Davis-Autonomy-Club/delivery-robot/docs/CURRENT_AMAZON_CART_SYNC.md

# Current Amazon Cart Sync

Updated after the manual Amazon cart trim on May 16, 2026.

This file records what is actually in the active Amazon cart so the repo does not drift away from the purchase state. It does not replace the full bill of materials in [`SHOPPING_LIST.md`](SHOPPING_LIST.md): the robot also needs the Pololu cart and any items marked below as already-owned, lab-supplied, or not currently active.

## Active Cart Summary

- Active Amazon cart: 36 line items, 38 units.
- Amazon subtotal shown in cart: $617.05 before tax and shipping.
- Pololu cart verified live on May 16, 2026: $379.35 before tax and shipping.
- Combined pre-tax purchase subtotal if the Pololu cart is unchanged: $996.40.

## Active Pololu Cart Items

| Qty | Active Pololu item | Product | Each | Line |
| ---: | --- | --- | ---: | ---: |
| 4 | 30:1 Metal Gearmotor 37Dx68L mm 12V with 64 CPR Encoder | [#4752](https://www.pololu.com/product/4752) | $60.95 | $243.80 |
| 4 | Machined Aluminum Bracket for 37D mm Metal Gearmotors | [#1995](https://www.pololu.com/product/1995) | $12.95 | $51.80 |
| 2 | 12 mm Hex Wheel Adapter for 6 mm Shaft, 2-pack | [#2686](https://www.pololu.com/product/2686) | $6.95 | $13.90 |
| 2 | 5 V, 5 A Step-Down Voltage Regulator D24V50F5 | [#2851](https://www.pololu.com/product/2851) | $29.95 | $59.90 |
| 1 | ACS724LLCTR-30AU Current Sensor Carrier 0 A to 30 A | [#4046](https://www.pololu.com/product/4046) | $9.95 | $9.95 |

## Active Amazon Cart Items

| Qty | Active Amazon item | ASIN | Cart price |
| ---: | --- | --- | ---: |
| 1 | B6 80W LiPo balance charger | [B0F2H3XR6S](https://www.amazon.com/dp/B0F2H3XR6S) | $38.98 |
| 1 | Foam edge bumper | [B086Z5B5B5](https://www.amazon.com/dp/B086Z5B5B5) | $9.99 |
| 1 | MC-31B lid reed switch 2-pack | [B0BX2ZRZ8T](https://www.amazon.com/dp/B0BX2ZRZ8T) | $9.99 |
| 1 | 22 mm NC emergency stop 2-pack | [B07R8PTTDX](https://www.amazon.com/dp/B07R8PTTDX) | $11.99 |
| 1 | Waterproof cable gland kit | [B09Z24H77M](https://www.amazon.com/dp/B09Z24H77M) | $12.99 |
| 1 | USB A-to-B Mega cable | [B00P0FO1P0](https://www.amazon.com/dp/B00P0FO1P0) | $5.99 |
| 1 | BTS7960 motor driver 4-pack | [B0FND3VTGK](https://www.amazon.com/dp/B0FND3VTGK) | $22.99 |
| 1 | Arduino Mega 2560 Rev3 | [B0046AMGW0](https://www.amazon.com/dp/B0046AMGW0) | $49.90 |
| 1 | 22 AWG silicone signal wire kit | [B0DWJSB65V](https://www.amazon.com/dp/B0DWJSB65V) | $14.99 |
| 1 | M2 screw/nut kit | [B0FGV5K8BT](https://www.amazon.com/dp/B0FGV5K8BT) | $9.99 |
| 1 | Prototype perfboard kit | [B072Z7Y19F](https://www.amazon.com/dp/B072Z7Y19F) | $9.99 |
| 1 | Resistor assortment | [B07P3MFG5D](https://www.amazon.com/dp/B07P3MFG5D) | $12.99 |
| 1 | Short USB cable assortment | [B0BZYKPCR5](https://www.amazon.com/dp/B0BZYKPCR5) | $13.99 |
| 1 | EIOTCLUB LTE data SIM | [B0DJ2SQZTQ](https://www.amazon.com/dp/B0DJ2SQZTQ) | $7.00 |
| 1 | Waveshare SIM7600G-H LTE USB dongle | [B08CSB596W](https://www.amazon.com/dp/B08CSB596W) | $78.71 |
| 2 | Arducam 1080p USB camera module | [B0CGLW3Z1N](https://www.amazon.com/dp/B0CGLW3Z1N) | $39.99 each |
| 1 | USB-C power pigtail 5-pack | [B0BFHXWCS9](https://www.amazon.com/dp/B0BFHXWCS9) | $9.99 |
| 1 | MG90S metal gear micro servo 2-pack | [B0BWJ4RKGV](https://www.amazon.com/dp/B0BWJ4RKGV) | $8.88 |
| 2 | Zeee 3S 5200 mAh XT60 LiPo | [B0972RKJDS](https://www.amazon.com/dp/B0972RKJDS) | $34.99 each |
| 1 | Precision screwdriver set | [B0D633J3C7](https://www.amazon.com/dp/B0D633J3C7) | $9.99 |
| 1 | Heat-shrink tubing kit | [B01MFA3OFA](https://www.amazon.com/dp/B01MFA3OFA) | $7.99 |
| 1 | XT60 pigtail kit | [B09M6KQWBL](https://www.amazon.com/dp/B09M6KQWBL) | $11.99 |
| 1 | Dupont jumper wire kit | [B01EV70C78](https://www.amazon.com/dp/B01EV70C78) | $6.98 |
| 1 | 18 AWG silicone wire | [B07FMRDP87](https://www.amazon.com/dp/B07FMRDP87) | $12.98 |
| 1 | 14 AWG silicone wire | [B0746H96QK](https://www.amazon.com/dp/B0746H96QK) | $9.88 |
| 1 | Silicone mat set | [B0CFTP6JR4](https://www.amazon.com/dp/B0CFTP6JR4) | $8.99 |
| 1 | Small zip ties | [B0DS6B9W4X](https://www.amazon.com/dp/B0DS6B9W4X) | $2.99 |
| 1 | M3 nylon standoff kit | [B0F297R23T](https://www.amazon.com/dp/B0F297R23T) | $8.59 |
| 1 | M3 x 8 screws | [B07CMQ1SQH](https://www.amazon.com/dp/B07CMQ1SQH) | $6.96 |
| 1 | M3 nyloc nuts | [B0DZ2V6PRF](https://www.amazon.com/dp/B0DZ2V6PRF) | $4.99 |
| 1 | M3 washers | [B0DDTNVRZW](https://www.amazon.com/dp/B0DDTNVRZW) | $5.49 |
| 1 | M3 x 20-40 screw assortment | [B0CR35WB16](https://www.amazon.com/dp/B0CR35WB16) | $9.79 |
| 1 | M3 x 12 screws | [B07CNFTK99](https://www.amazon.com/dp/B07CNFTK99) | $6.96 |
| 1 | 5 V red LED strip | [B0CMCN9Z2K](https://www.amazon.com/dp/B0CMCN9Z2K) | $6.19 |
| 1 | HC-SR04 ultrasonic sensors 2-pack | [B0B1MJJLJP](https://www.amazon.com/dp/B0B1MJJLJP) | $6.99 |
| 1 | XT60 loop/main switch | [B0B1C88LSM](https://www.amazon.com/dp/B0B1C88LSM) | $9.99 |

## Robot-Relevant Items Not In The Active Cart

These were visible outside the active cart or are required by the build but absent from the current active Amazon cart. Do not start the build unless each one is either already on hand, bought elsewhere, or deliberately replaced with an equivalent part.

| Item | Current cart state | Why it still matters |
| --- | --- | --- |
| 120 mm / 12 mm-hex wheel set, [B09KTKGZGF](https://www.amazon.com/dp/B09KTKGZGF) | Saved for later, not active | Required for the drivetrain unless a compatible wheel set is already on hand. |
| Automotive blade fuse kit, [B0899WR671](https://www.amazon.com/dp/B0899WR671) | Saved for later, not active | Required for the fused battery input unless matching 25 A and 30 A fuses are already on hand. |
| Inline blade fuse holders, [B07426WCLM](https://www.amazon.com/dp/B07426WCLM) | Saved for later, not active | Required near battery positive unless an equivalent rated fuse holder is already on hand. |
| WAGO 221 distribution connectors, [B0CJ5QF3VX](https://www.amazon.com/dp/B0CJ5QF3VX) | Saved for later, not active | Required unless an equivalent rated positive/negative distribution block is used. |
| White PETG filament, [B07PDV9RC8](https://www.amazon.com/dp/B07PDV9RC8) | Removed from cart | Required unless PETG/PLA filament is already available from the lab. |
| Clear/natural PETG or PLA | Not active | Only needed for the front LED diffuser; can be skipped if the diffuser is omitted. |
| Raspberry Pi 4 and microSD card | Not active | Required for the current two-camera/LTE plan unless a Pi and microSD are already on hand. |
| Velcro battery straps | Not active | Required to restrain the battery unless an equivalent strap is already on hand. |
| LiPo-safe charging bag | Not active | Required for safe LiPo charging/storage unless the existing Zeee bag is being used. |
| Multimeter, wire stripper, crimper/soldering iron, needle-nose pliers, hex keys, flush cutters | Not active | Required tools; okay to omit from cart only if the shop/lab already has them. |
| 3D printer | Not active | Fine to omit if printing is outsourced or a printer is already available. |

Known saved-for-later add-back subtotal for wheels, fuses, fuse holders, and WAGO connectors is at least $68.82 before tax/shipping. The real all-in build cost is therefore above the $996.40 active-cart subtotal unless those items are already owned or replaced by equivalents.

## Compatibility Notes From This Sync

- The current Amazon cart is below the $1,000 pre-tax target only because several required build/support items are not active in Amazon.
- Cameras, LTE modem, USB-C pigtails, and short USB cables are active, but the Raspberry Pi and microSD card are not. That is compatible only if a Pi and microSD are already available.
- The B6 charger is still active even though an OVONIC X1 Dual charger may be available. If the OVONIC charger will be used, remove the B6 charger from the Amazon cart and mark the charger as already-owned in `SHOPPING_LIST.md`.
- XT60 pigtails are still active even though MCIGICM XT60H connectors may be available. Keeping the pigtail kit is reasonable for quick wiring; delete it only if the team is comfortable soldering XT60H connectors directly.
