Davis-Autonomy-Club/delivery-robot/cad/print-ready/full-size/v2_robot_complete_reference_not_for_print.stl

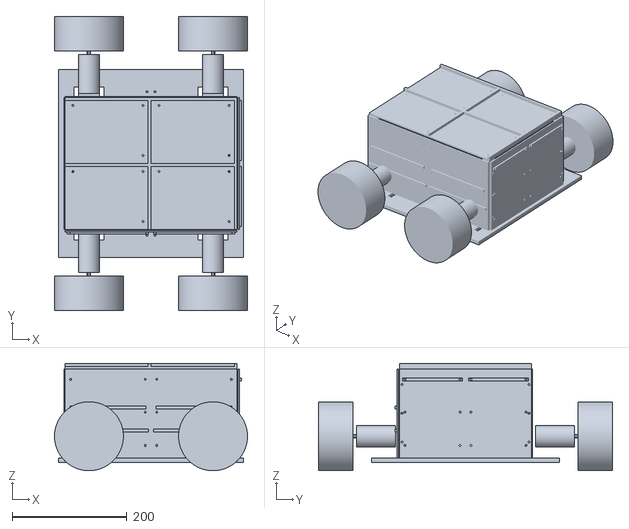
[picture p1: CAD file, 2026-05-16]
cad/print-ready/full-size/v2_robot_complete_reference_not_for_print.stl
336.0 x 512.0 x 187.0
