Davis-Autonomy-Club/delivery-robot/cad/print-ready/full-size/v2_base_plate_full_size.stl

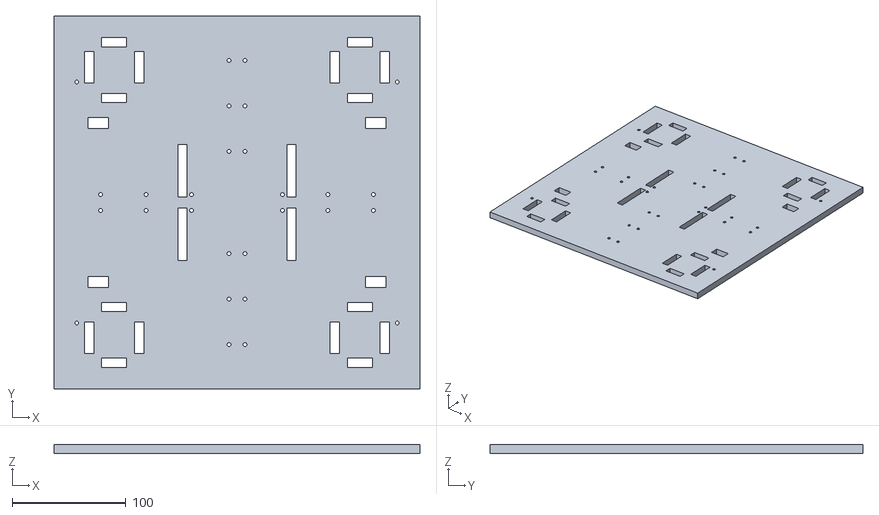
[picture p2: CAD file, 2026-05-16]
cad/print-ready/full-size/v2_base_plate_full_size.stl
322.0 x 328.0 x 8.00
