Davis-Autonomy-Club/delivery-robot/cad/print-ready/full-size/original_four_piece_base_merged_full_size.stl

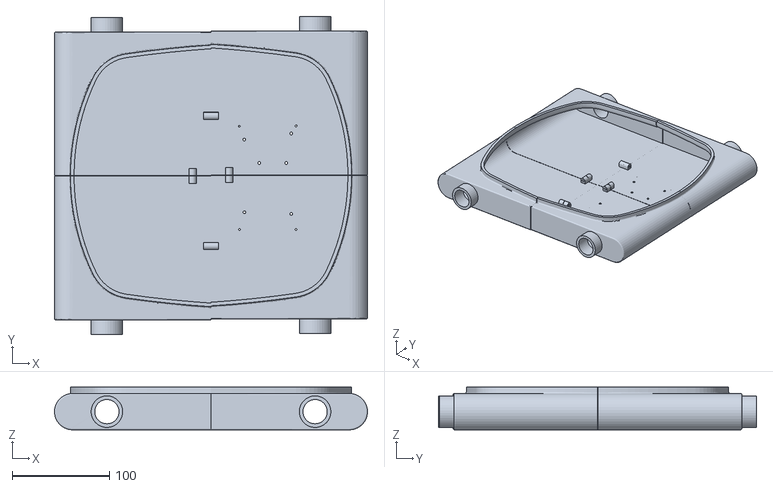
[picture p3: CAD file, 2026-05-16]
cad/print-ready/full-size/original_four_piece_base_merged_full_size.stl
322.3 x 327.6 x 44.0
