Davis-Autonomy-Club/delivery-robot/cad/print-ready/body/side_panel_front_half_print_2.stl

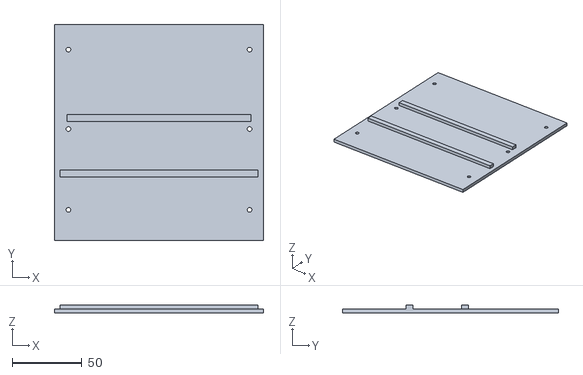
[picture p4: CAD file, 2026-05-16]
cad/print-ready/body/side_panel_front_half_print_2.stl
150.0 x 155.0 x 6.00
