Davis-Autonomy-Club/delivery-robot/cad/print-ready/cargo/cargo_floor_rear_right.stl

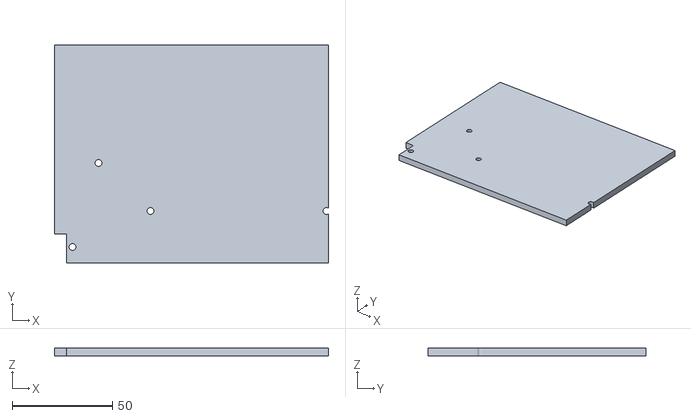
[picture p5: CAD file, 2026-05-16]
cad/print-ready/cargo/cargo_floor_rear_right.stl
137.0 x 109.0 x 4.00
