Davis-Autonomy-Club/delivery-robot/cad/print-ready/chassis/base_plate_front_left.stl

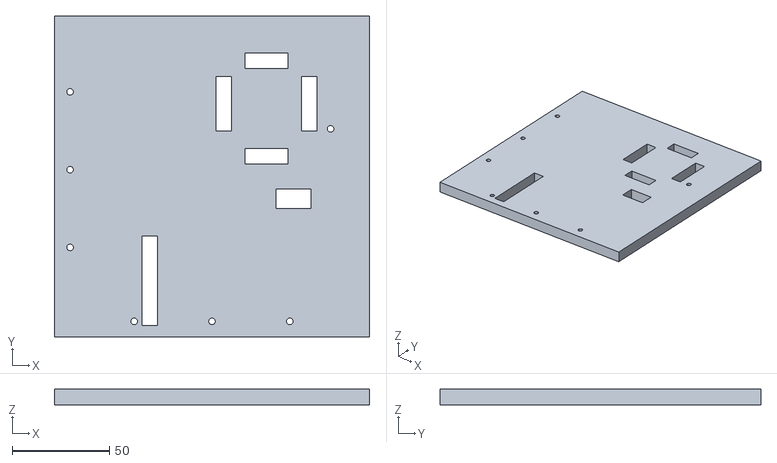
[picture p6: CAD file, 2026-05-16]
cad/print-ready/chassis/base_plate_front_left.stl
162.0 x 165.0 x 8.00
