Davis-Autonomy-Club/delivery-robot/cad/print-ready/electronics/buck_converter_plate.stl

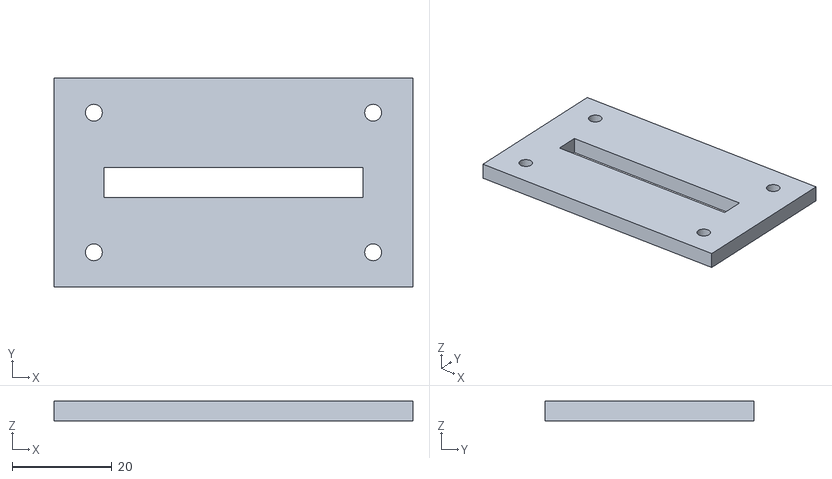
[picture p7: CAD file, 2026-05-16]
cad/print-ready/electronics/buck_converter_plate.stl
72.0 x 42.0 x 4.00
