Davis-Autonomy-Club/delivery-robot/cad/print-ready/body/rear_panel_left.stl

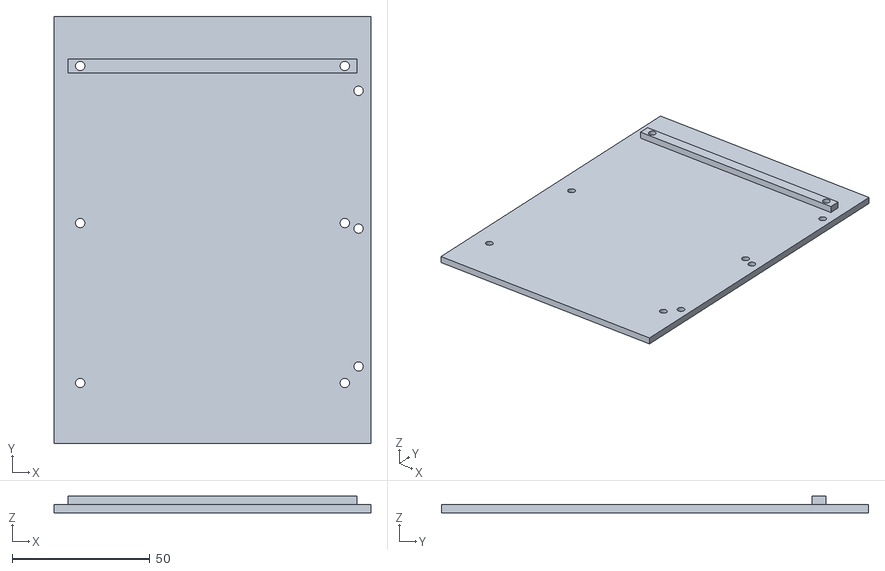
[picture p8: CAD file, 2026-05-16]
cad/print-ready/body/rear_panel_left.stl
115.0 x 155.0 x 6.00
