Davis-Autonomy-Club/delivery-robot/cad/print-ready/chassis/base_seam_joiner_short_print_2.stl

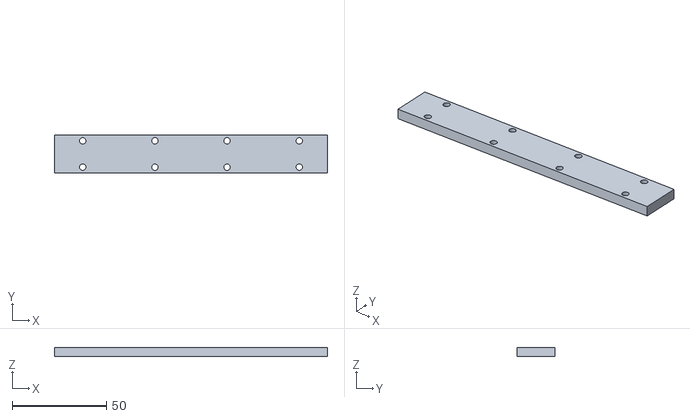
[picture p9: CAD file, 2026-05-16]
cad/print-ready/chassis/base_seam_joiner_short_print_2.stl
145.0 x 20.0 x 5.00
