Davis-Autonomy-Club/delivery-robot/cad/print-ready/electronics/bts7960_dual_driver_tray_print_2.stl

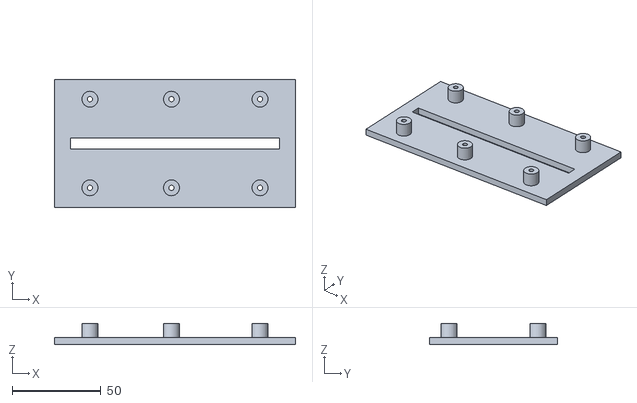
[picture p10: CAD file, 2026-05-16]
cad/print-ready/electronics/bts7960_dual_driver_tray_print_2.stl
136.0 x 72.0 x 12.0
