Davis-Autonomy-Club/delivery-robot/cad/print-ready/electronics/3s_lipo_battery_sled.stl

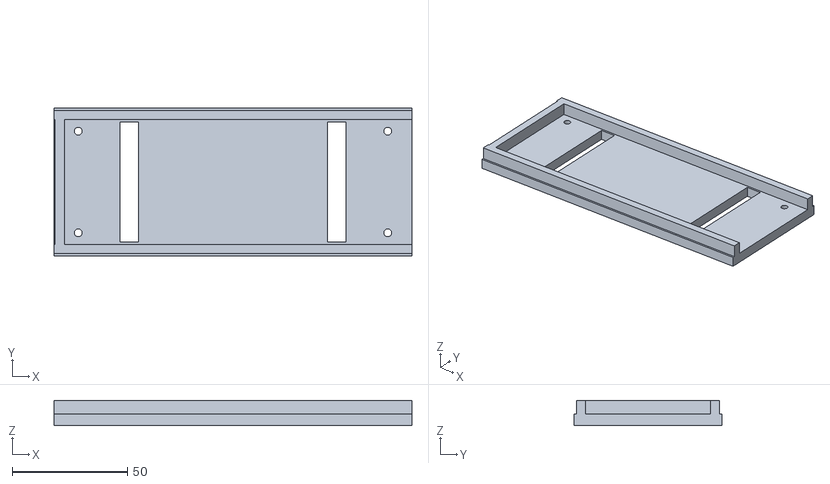
[picture p11: CAD file, 2026-05-16]
cad/print-ready/electronics/3s_lipo_battery_sled.stl
155.0 x 64.0 x 11.0
