Davis-Autonomy-Club/delivery-robot/cad/print-ready/body/corner_post_print_4.stl

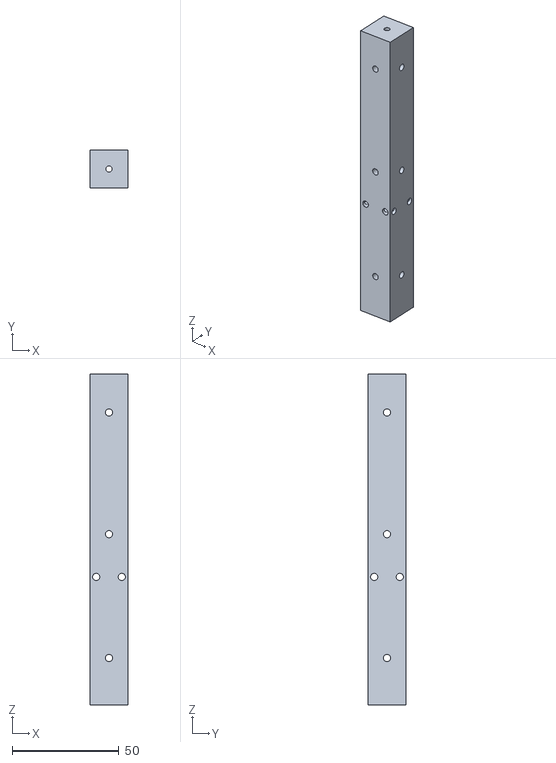
[picture p12: CAD file, 2026-05-16]
cad/print-ready/body/corner_post_print_4.stl
18.0 x 18.0 x 155.0
