Davis-Autonomy-Club/delivery-robot/cad/print-ready/electronics/arduino_mega_controller_tray.stl

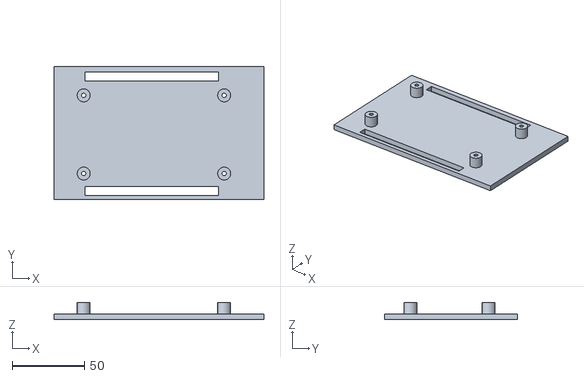
[picture p13: CAD file, 2026-05-16]
cad/print-ready/electronics/arduino_mega_controller_tray.stl
145.0 x 92.0 x 12.0
