Davis-Autonomy-Club/delivery-robot/cad/print-ready/body/panel_center_joiner_print_4.stl

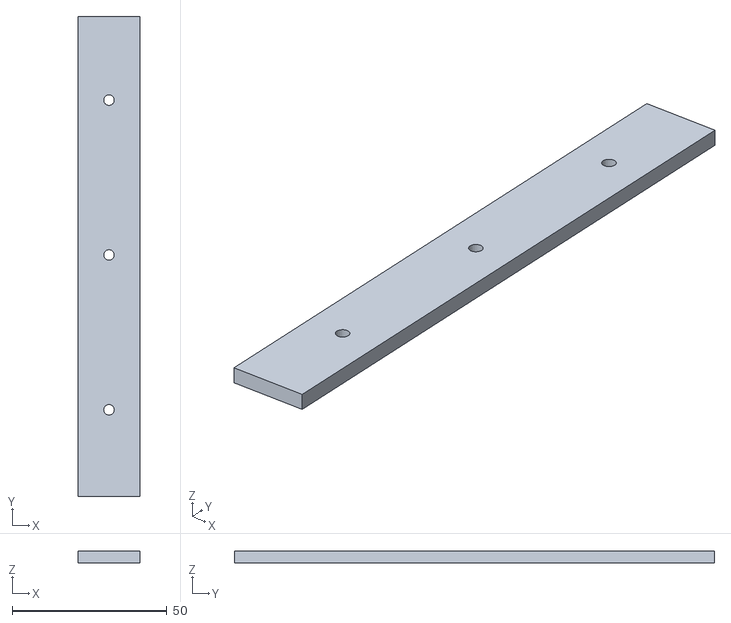
[picture p14: CAD file, 2026-05-16]
cad/print-ready/body/panel_center_joiner_print_4.stl
20.0 x 155.0 x 4.00
