Davis-Autonomy-Club/delivery-robot/cad/print-ready/cargo/cargo_shelf_support_block_print_4.stl

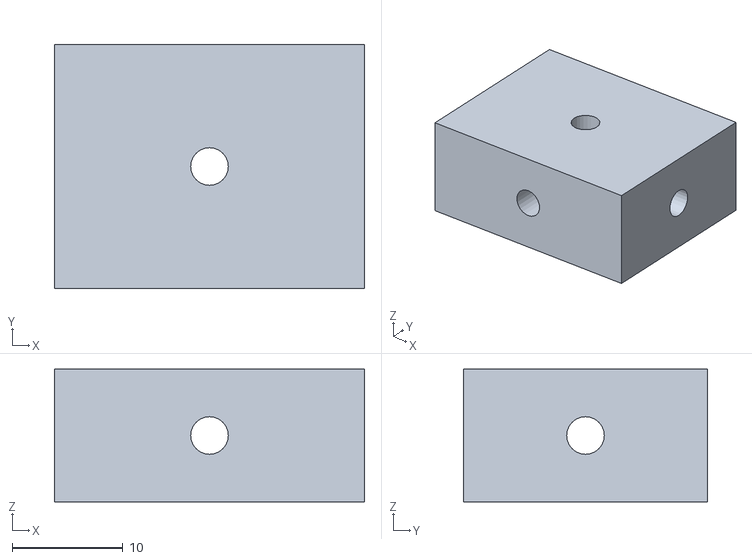
[picture p15: CAD file, 2026-05-16]
cad/print-ready/cargo/cargo_shelf_support_block_print_4.stl
28.0 x 22.0 x 12.0
