Davis-Autonomy-Club/delivery-robot/cad/print-ready/chassis/base_seam_joiner_long_print_2.stl

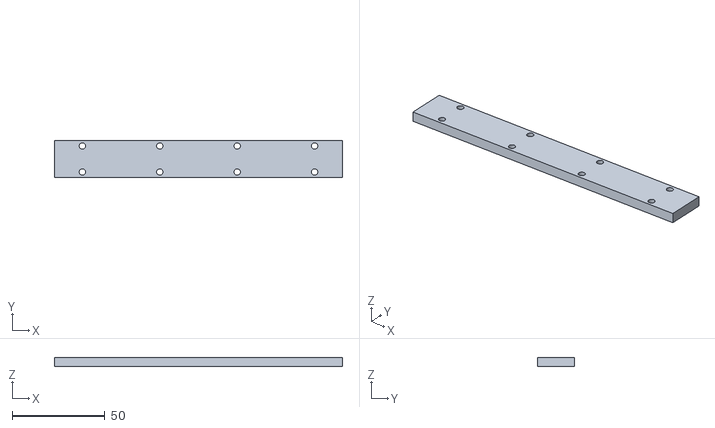
[picture p16: CAD file, 2026-05-16]
cad/print-ready/chassis/base_seam_joiner_long_print_2.stl
155.0 x 20.0 x 5.00
