Davis-Autonomy-Club/delivery-robot/cad/print-ready/body/lid_quadrant_print_4.stl

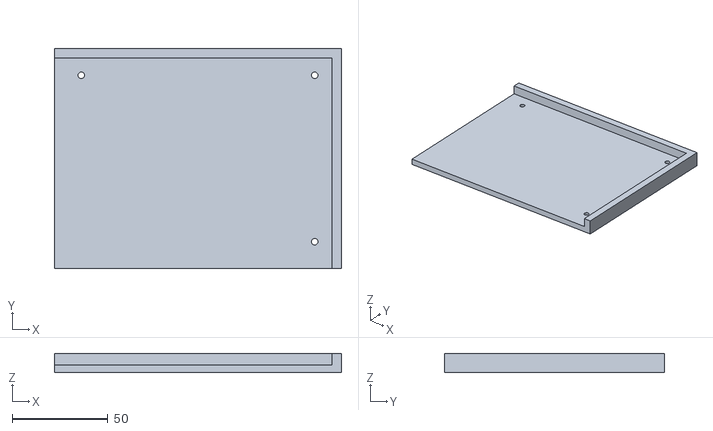
[picture p17: CAD file, 2026-05-16]
cad/print-ready/body/lid_quadrant_print_4.stl
150.0 x 115.0 x 10.0
