Davis-Autonomy-Club/delivery-robot/(list of files, cad)

Other CAD files:
cad/print-ready/cargo/cargo_floor_rear_left.stl
cad/print-ready/body/side_panel_rear_half_print_2.stl
cad/print-ready/cargo/cargo_floor_front_right.stl
cad/print-ready/chassis/base_plate_front_right.stl
cad/print-ready/cargo/cargo_floor_front_left.stl
cad/print-ready/chassis/base_plate_rear_left.stl
cad/print-ready/chassis/base_plate_rear_right.stl
cad/print-ready/body/front_panel_right.stl
cad/print-ready/body/rear_panel_right.stl
