Davis-Autonomy-Club/delivery-robot/(commit log)

2026-05-16 Add delivery robot CAD deliverables
    [3s_lipo_battery_sled.stl, OPEN_ME_complete_robot_reference.stl, OPEN_ME_full_base_plate_reference.stl, arduino_mega_controller_tray.stl, base_plate_front_left.stl, base_plate_front_right.stl, base_plate_rear_left.stl, base_plate_rear_right.stl]
2026-05-16 Add v2.1 delivery robot upgrades
    [OPEN_ME_complete_robot_reference.stl, battery_telemetry_sensor_plate.stl, buck_converter_plate_print_2.stl, camera_module_mount_print_2.stl, front_panel_left_hcsr04_led.stl, front_panel_right_hcsr04_led.stl, lid_lock_keeper_plate.stl, lid_lock_servo_cam.stl]
2026-05-16 Simplify delivery robot for outdoor baseline
    [OPEN_ME_complete_robot_reference.stl, battery_telemetry_sensor_plate.stl, buck_converter_plate.stl, camera_module_mount_print_2.stl, cargo_retainer_long_rail_print_2.stl, cargo_retainer_short_rail_print_2.stl, front_led_diffuser_clear_print_1.stl, front_panel_left.stl]
